dodgymike/bsidescpt2016badge/README.md

# bsidescpt2017badge
Repo for server code + board designs
