dodgymike/bsidescpt2016badge/(commit log)

2016-06-13 Added an old and unfinished design
    [zaconBadge.sch]
2016-06-19 Add AndrewMac's contributions
    [badgeBreadboard.fz, badgeBreadboard.fzz]
2016-06-22 Working prototype
2016-06-27 Added PCB designs + laser-cut-cover
    [badge-dc24.kicad_pcb, badge-dc24.sch]
2016-06-27 Added Nokia 5110 LCD
    [badge-dc24.kicad_pcb, badge-dc24.sch]
2016-06-28 Final layout without LCD
    [badge-dc24-with-lcd.kicad_pcb, badge-dc24.sch]
2016-06-28 SMD fir some components
    [badge-dc24-with-lcd.kicad_pcb, badge-dc24.sch]
2016-06-30 Added LCD + headers
    [badge-dc24.sch]
2016-06-30 Almost there
    [badge-dc24-with-lcd.kicad_pcb]
2016-06-30 Moved components out from under LCD
    [badge-dc24-with-lcd.kicad_pcb]
2016-06-30 Moved IR LED to the corner, for neatness' sake
    [badge-dc24-with-lcd.kicad_pcb]
2016-07-03 Moved reg marks + fixed temp tx wire problem
    [badge-dc24-with-lcd.kicad_pcb, badge-dc24.sch]
2016-07-14 New design based on learnings from first design
    [badge-dc24-with-lcd.kicad_pcb, badge-dc24.sch]
2016-07-14 Added previous git ref to front copper
    [badge-dc24-with-lcd.kicad_pcb]
2016-07-14 Added board rev
    [badge-dc24-with-lcd.kicad_pcb]
2016-07-14 LEDs to throughole
    [badge-dc24-with-lcd.kicad_pcb, badge-dc24.sch]
2016-07-26 Model update
    [defection_domination_10k.csv, defection_no-domination_10k.csv, no-defection_no-domination_10k.csv]
2016-07-26 Moving over to SMD
    [badge-dc24-with-lcd-all-smd.kicad_pcb, badge-dc24.sch]
2016-07-26 Added regulator for 5v power
    [badge-dc24.sch]
2016-07-26 Changed git commit sha on board
    [badge-dc24-with-lcd-all-smd.kicad_pcb]
2016-07-26 More SMD components
    [badge-dc24-with-lcd-all-smd.kicad_pcb, badge-dc24-with-lcd.kicad_pcb, badge-dc24.sch]
2016-07-29 v0.3 with SMD
    [badge-dc24-with-lcd-all-smd.kicad_pcb, badge-dc24-with-lcd.kicad_pcb, badge-dc24.sch]
2016-07-29 Thicker tracks
    [badge-dc24-with-lcd-all-smd.kicad_pcb]
2016-07-29 Updated git version
    [badge-dc24-with-lcd-all-smd.kicad_pcb]
2016-07-29 Added USB mini socket
    [badge-dc24-with-lcd-all-smd.kicad_pcb, badge-dc24.sch]
2016-07-29 v0.3 update
    [badge-dc24-with-lcd-all-smd.kicad_pcb]
2016-07-29 Moved IR LED into a central position
    [badge-dc24-with-lcd-all-smd.kicad_pcb]
2016-07-29 Updated git ref
    [badge-dc24-with-lcd-all-smd.kicad_pcb]
2016-08-22 Mostly working
    [badge-dc24-with-lcd-all-smd-and-breakout.kicad_pcb]
2016-08-22 Fixed IR pin-swap and regulator pin-swap
    [badge-dc24-with-lcd-all-smd-and-breakout.kicad_pcb, badge-dc24.sch]
2016-08-22 Updated git ref on board
    [badge-dc24-with-lcd-all-smd-and-breakout.kicad_pcb]
2016-09-07 v0.4 PCB layout
2016-09-11 last v0.6
    [badge-bsides-v0.6.kicad_pcb]
2016-09-17 v0.7 with rs232 -> usb chip
    [Seeed_OPL_List_download-20160608.ods, badge-bsides-v0.7.kicad_pcb, badge-dc24.sch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]
2016-09-17 v0.7 with Table Mountain
    [badge-bsides-v0.7.kicad_pcb]
2016-09-18 added exclusion zone for antenna
    [badge-bsides-v0.7.kicad_pcb]
2016-09-18 added mountain and names
    [badge-bsides-v0.7.kicad_pcb]
2016-09-18 Centered Table Mountain, and moved labels to the back
    [badge-bsides-v0.7.kicad_pcb]
2016-09-18 Added holes and dimensions
    [badge-bsides-v0.7.kicad_pcb]
2016-09-18 Removed some unnecessary tracks
    [badge-bsides-v0.7.kicad_pcb]
2016-09-18 Small track fixes
    [badge-bsides-v0.7.kicad_pcb]
2016-09-18 More track cleanup
    [badge-bsides-v0.7.kicad_pcb]
2016-09-20 Added lanyard etc
    [badge-bsides-v0.7.kicad_pcb, badge-dc24.sch]
2016-09-25 Added leadership model with dynamic defecting
    [1in10defect.csv, 1in10defect2.csv, 1in10defect3.csv, beforemodification.csv, defectBasedOnLevel.csv, defectBasedOnLevel2.csv, defectBasedOnLevel3.csv]
2016-09-26 Charger circuit PCB
    [badge-bsides-v0.7.kicad_pcb, badge-dc24.sch]
2016-09-26 Added git commit
    [badge-bsides-v0.7.kicad_pcb]
2016-09-28 Removed unnecessary via that was causing a zone fill in the right 'eye'
    [badge-bsides-v0.7.kicad_pcb]
2016-09-28 Updated git ref text
    [badge-bsides-v0.7.kicad_pcb]
2016-09-28 Redo super-thin track
    [badge-bsides-v0.7.kicad_pcb]
2016-09-28 Updated git ref + rev
    [badge-bsides-v0.7.kicad_pcb]
2016-10-06 Fix for charger LED + ESP GND
    [badge-bsides-v0.7.kicad_pcb, badge-dc24.sch]
2016-10-06 Cleaner power/charger circuit
    [badge-bsides-v0.7.kicad_pcb]
2016-10-06 Fixed missing 3.3v line
    [badge-bsides-v0.7.kicad_pcb]
2016-10-10 More decoupling caps + moved USB connector + better USB line routing
    [badge-bsides-v0.7.kicad_pcb, badge-dc24.sch]
2016-10-11 v0.7.4 with two charging LEDs
    [badge-bsides-v0.7.kicad_pcb, badge-dc24.sch]
2016-10-11 Fixed accidentally removed button via
    [badge-bsides-v0.7.kicad_pcb]
2016-10-13 Added cut lines
    [badge-bsides-v0.7.kicad_pcb]
2016-10-13 v0.7.4 fix for Seeed
    [badge-bsides-v0.7-B.Cu.gbl, badge-bsides-v0.7-B.Cu.gbr, badge-bsides-v0.7-B.Mask.gbs, badge-bsides-v0.7-B.SilkS.gbo, badge-bsides-v0.7-B.SilkS.gbr, badge-bsides-v0.7-Edge.Cuts.gm1, badge-bsides-v0.7-F.Cu.gbr, badge-bsides-v0.7-F.Cu.gtl]
2017-01-09 v0.7.4 finals
    [badge-v0.7.4-pnp.csv, paper-badges.kicad_pcb]
2017-01-09 Cleanup + remove, to prepare for v0.8+
    [1in10defect.csv, 1in10defect2.csv, 1in10defect3.csv, badge-bsides-v0.6.kicad_pcb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]
2017-01-09 More cleanup
    [Seeed_OPL_List_download-20160608.ods, badge-bsides-v0.7.kicad_pcb, badge-dc24.sch]
